openclaw068/SteadyStud/steadystud/morning_summary.txt

SteadyStud quote tracker — 2026-03-31 08:03 UTC
New quote-ish emails since last run: 45

- 2026-03-30 | Monica Devi <cs2@decimal.net> | RE: RFQ — SteadyStud — metal part + laser logo marking — Qty 50 / 100 / 500 / 1000 | 
- 2026-03-30 | Jason Lasica <jason@pittsburghlasercutting.com> | Re: RFQ — SteadyStud — metal part + laser logo marking — Qty 50 / 100 / 500 / 1000 | $125, $1,500, $500, $2,500
- 2026-03-30 | shanice@jlcpcb.com | Re: RFQ — SteadyStud — metal part + laser logo marking — Qty 50 / 100 / 500 / 1000 | 
- 2026-03-30 | magstud <magstud@agentmail.to> | RFQ — SteadyStud — metal part + laser logo marking — Qty 50 / 100 / 500 / 1000 | 
- 2026-03-30 | magstud <magstud@agentmail.to> | RFQ — SteadyStud — metal part + laser logo marking — Qty 50 / 100 / 500 / 1000 | 
- 2026-03-30 | magstud <magstud@agentmail.to> | RFQ — SteadyStud — metal part + laser logo marking — Qty 50 / 100 / 500 / 1000 | 
- 2026-03-30 | magstud <magstud@agentmail.to> | RFQ — SteadyStud — metal part + laser logo marking — Qty 50 / 100 / 500 / 1000 | 
- 2026-03-30 | magstud <magstud@agentmail.to> | RFQ — SteadyStud — metal part + laser logo marking — Qty 50 / 100 / 500 / 1000 | 
- 2026-03-30 | magstud <magstud@agentmail.to> | RFQ — SteadyStud — metal part + laser logo marking — Qty 50 / 100 / 500 / 1000 | 
- 2026-03-30 | magstud <magstud@agentmail.to> | RFQ — SteadyStud — metal part + laser logo marking — Qty 50 / 100 / 500 / 1000 | 
(+35 more)
