openclaw068/SteadyStud/steadystud/README_START_HERE.md

# SteadyStud — START HERE

## Current source of truth
- **v2 - reviewed (2026-03-14)/** ← canonical “current” folder

## Working areas
- **RFQs/** ← supplier outreach, quotes, and attachments (AgentMail exports)
- **02 - Product & Design/** ← CAD, specs, product design notes
- **03 - Manufacturing & Supply Chain/** ← manufacturing plan, DFM, cost-down
- **04 - Branding & Positioning/**
- **05 - Go-To-Market & Channels/**
- **06 - Financial Model/**
- **07 - Risks, Legal, IP/**
- **08 - Experiments & Roadmap/**

## Archive
- **_archive/** ← older drafts and duplicates moved here to keep the root clean

If something is missing, check `_archive/` before assuming it was deleted.
