openclaw068/SteadyStud/audits/RFQs/RFQ - Anodize + Laser.md

# RFQ — Anodize + Laser Mark (SteadyStud)

Hi {VendorName},

I’m looking for a quote to finish and laser-mark small aluminum parts for a handheld tool called **SteadyStud**.

## Project: SteadyStud (premium magnetic stud finder)

**Quantity tiers to quote:** 200 / 500 / 1000 units

**Material:** 6061-T6 aluminum (confirm if alternative alloy materially cheaper)

**Finish:** Type II anodize — *use the cheapest standard color you already run* (clear or black often cheapest; quote both if price differs). No dye-matching requirement.

**Branding:** laser marking only (logo + minimal text). No paint fill.

**Magnets:** we will install magnets ourselves for the first run (quote part without magnets).

**Files provided (intake):** STEP v1 + supporting DWG/DXF as needed.

**Shipping:** deliver to ZIP 55117.

**Notes:** This is a pro tool meant to slide on painted drywall; edges must be wall-safe.

## Scope requested
1) **Type II anodize** (cheapest standard color you run; quote clear vs black if different)
2) **Laser mark**: logo + minimal text on one face (vector artwork will be provided)

## Quality requirements
- Cosmetic: consistent color within a batch
- Functional: edges must remain smooth/wall-safe after finishing

## Quote format
Please include:
- Minimum batch charges
- Unit price at 200 / 500 / 1000
- Lead time
- Any prep requirements (masking, racking points, pre-finish expectations)

Thanks,
{YourName}
{Phone}
