openclaw068/SteadyStud/audits/RFQs/RFQ - Machine Shop.md

# RFQ — Machine shop (SteadyStud)

Hi {ShopName},

I’m looking for a quote for a small production run of an aluminum handheld tool called **SteadyStud**.

## Project: SteadyStud (premium magnetic stud finder)

**Quantity tiers to quote:** 200 / 500 / 1000 units

**Material:** 6061-T6 aluminum (confirm if alternative alloy materially cheaper)

**Finish:** Type II anodize — *use the cheapest standard color you already run* (clear or black often cheapest; quote both if price differs). No dye-matching requirement.

**Branding:** laser marking only (logo + minimal text). No paint fill.

**Magnets:** we will install magnets ourselves for the first run (quote part without magnets).

**Files provided (intake):** STEP v1 + supporting DWG/DXF as needed.

**Shipping:** deliver to ZIP 55117.

**Notes:** This is a pro tool meant to slide on painted drywall; edges must be wall-safe.

## Scope requested
Please quote as separate line items (so we can mix-and-match suppliers):
1) **Blank + machining** (no finish)
2) **Deburr + edge break / tumble** (wall-safe)
3) **Packaging for shipment** (bulk pack OK; no retail packaging)

## Manufacturing approach
We’re aiming for a cost-effective approach compatible with:
- 0.25" plate blank (waterjet/laser) + limited CNC where required
- OR your recommended equivalent process for best cost/quality

## Tolerances
We are okay with **general machining tolerances** suitable for a hand tool (no press fits). Please call out any features that would drive time/cost.

## Quote format
Please include:
- Unit price at 200 / 500 / 1000
- Setup/NRE charges
- Lead time
- Assumed process steps (cut method, CNC ops, deburr/tumble)
- Any DFM recommendations to reduce cost while preserving a stiff, solid feel

Thanks,
{YourName}
{Phone}
