openclaw068/SteadyStud/audits/01 - Market & Customer Research/SteadyStud - Research Notes (Cited).md

# SteadyStud — Research notes (cited)

## 1) Category basics: magnetic stud finders
Magnetic stud finders locate studs by detecting **metal fasteners** (nails/screws) used to secure drywall to studs; users typically confirm by finding multiple fasteners and inferring stud location/spacing.

Source: Wikipedia — Stud finder (Magnetic stud finders section): https://en.wikipedia.org/wiki/Stud_finder

## 2) What credible reviewers recommend (signals for pro-speed positioning)
### Wirecutter (NYT) — prefers magnetic for reliability
Wirecutter states electronic stud finders are often unreliable and highlights magnetic stud finders as simple and reliable; recommends the C.H. Hanson 03040 as top pick and notes that the pointed end + onboard level simplify marking.

Source: NYT Wirecutter — The Best Stud Finder for Home Use: https://www.nytimes.com/wirecutter/reviews/best-stud-finder/

Implications for SteadyStud:
- “Fast and accurate” + “simple magnet” is a validated narrative.
- Marking and speed features matter (your notch is in the same family as “pointed end simplifies marking”).

## 3) Strong-magnet competitor claim (pro trades)
Rack-A-Tiers sells the “Stud Ball” and claims **27 lbs of pull** and detection through **up to 5/8" drywall** and **up to 3/4" plywood**.

Sources:
- Rack-A-Tiers product page: https://rack-a-tiers.com/product/stud-ball-magnetic-stud-finder/
- ConstructionFastening retailer page (repeats 27 lbs pull + material thickness claims): https://www.constructionfastening.net/Rack_A_Tiers_Stud_Ball_Stud_Finder_p/52300.htm

Implications:
- “Magnet strength” is a marketing axis pros will understand.
- If SteadyStud competes on pro-speed, we should define a clear magnet performance target and test protocol.

## 4) Commodity price anchor (tentative)
Home Depot listing snippets repeatedly show The StudBuddy model 000107 at **$10.97**.

Source (snippet only; direct fetch blocked by 403):
- Brave search results for Home Depot product page: https://www.homedepot.com/p/The-StudBuddy-Magnetic-Stud-Finder-000107/205554450

Implications:
- Premium pro-speed pricing ($15–$25) needs a clear reason to exist: faster workflow (marking notch), better wall-safe glide, stronger magnet feel, durability.

## Notes / hallucination controls
- Home Depot/Lowe’s pages are blocked in this environment (403), so prices from those pages are currently supported only by search snippets. We treat them as *directional* until confirmed by an accessible retailer source.
