openclaw068/SteadyStud/cad/v3/out/SteadyStud_v3A_drawing.pdf

# STEADYSTUD v3A — 2D-CUT ALUMINUM BODY, 3 X 1/2 X 1/4 IN MAGNET

Laser/waterjet profile from 0.250" plate. No machining. Dimensions in inches. Drawing generated from the laser DXF.

### FRONT FACE (marked side) — 1:1 when PDF printed at 100%

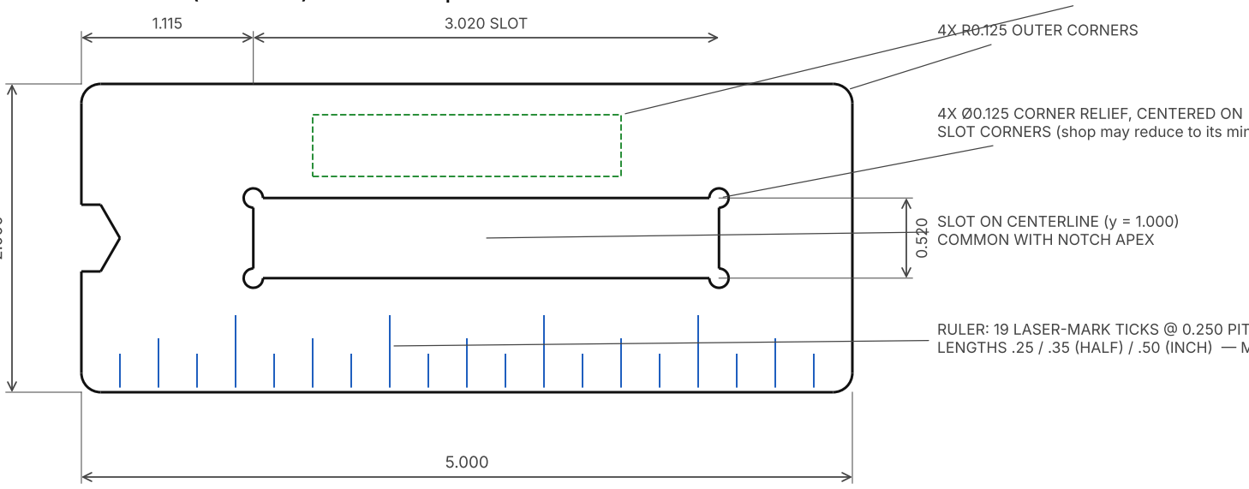
[picture p1: figure]
3.020 SLOT; 4X Ø0.125 CORNER RELIEF, CENTERED ON; SLOT ON CENTERLINE (y = 1.000); COMMON WITH NOTCH APEX; 4X R0.125 OUTER CORNERS

2.000

SLOT CORNERS (shop may reduce to its min hole)

RULER: 19 LASER-MARK TICKS @ 0.250 PITCH
LENGTHS .25 / .35 (HALF) / .50 (INCH) — MARK, NOT CUT

LOGO ZONE 2.00 x 0.40 (laser mark) — moved from v1

### DETAIL A — END NOTCH (2.5:1)

### unchanged from v1 STEP

0.433

0.125

0.250 TO APEX

60° INCLUDED V
℄

### SECTION B — THROUGH CENTERLINE (thickness shown 2:1)

MAGNET 3 x 1/2 x 1/4 in (magnetized through thickness)

BACK PAD (wall side) — see note 7 .250

SLOT 3.020 / MAGNET 3.000

Magnet bonded FLUSH TO BACK (wall) face. Any thickness mismatch is taken on the front face.

## NOTES

1. MATERIAL: 6061-T6 aluminum plate, 0.250" nominal.
2. PROCESS: through-cut profile only (fiber laser or waterjet). No milling, no chamfers.
3. TOLERANCES: profile ±0.005; slot +0.005/-0.000 vs nominal shown; thickness per mill plate.
4. EDGES: tumble/vibratory deburr. Break all edges .010–.020. No sharp edges (wall-safe).
5. FINISH: Type II anodize, black (alt: clear). Quote as-cut + tumbled as alternate.
6. MARKING: laser mark after anodize — layer MARK (ruler) and LOGO_ZONE. Not engraved.
7. BACK PAD: adhesive-backed PET felt or UHMW tape ≤0.5 mm, die-cut to SteadyStud_v3_back_pad.dxf (outline inset 0.020). Covers magnet; wall-contact face.
8. MAGNET: 3 x 1/2 x 1/4 in NdFeB N42, Ni-Cu-Ni, magnetized through thickness. Source: K&J Magnetics BZ084 (stock). Bond with 2-part epoxy; polarity uniform across lot.
9. USE: hold notch UP (long axis vertical). Mark at notch apex = fastener column = stud line.
STATUS | PROTOTYPE / RFQ — NOT RELEASED
DATE | 2026-10-12
UNITS | inch
SUPERSEDES | Stud Finer v1 (for quoting)
SOURCE | cad/v3/steadystud_v3.py
MAGNET | 3 x 1/2 x 1/4 in
PART | SteadyStud body v3A
