openclaw068/SteadyStud/cad/v3/out/SteadyStud_v3A_laser_marking_drawing.pdf

# STEADYSTUD v3A — LASER MARKING DRAWING (INCHES)

Grey = cut outline (reference only). BLACK = laser mark on the FRONT face. All dimensions in inches.

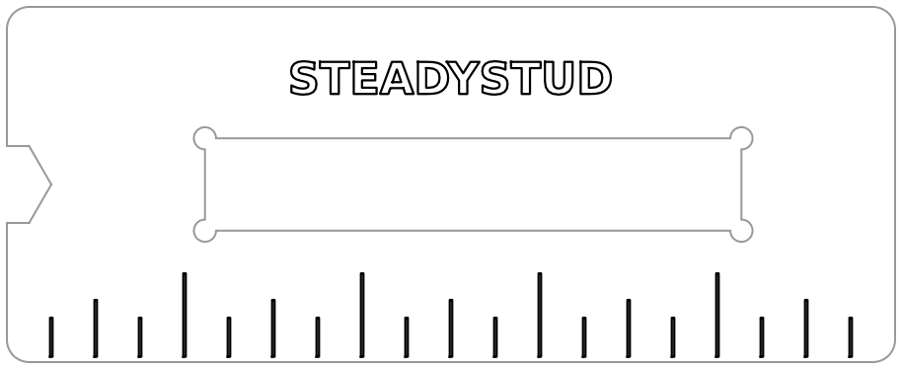
[picture p2: figure]

MARK 1 — RULER: 19 lines along the bottom long edge, 0.250 pitch, first line 0.250 from the notched end.

Line lengths: 0.250 at quarter-inch, 0.350 at half-inch, 0.500 at whole-inch positions. Line width ≈ 0.014.

Lines start 0.030 in from the edge. Positions measured from the notched end of the part.

MARK 2 — TEXT: "STEADYSTUD", about 1.80 × 0.19, centered in a 2.000 × 0.400 zone; zone center 2.500 from the notched end, 1.600 from the ruler edge.

FACE: front face only (notch on the LEFT, ruler along the BOTTOM edge). Do not mark the back.

Marks only — NOT cut or engraved through. Fill all closed BLACK shapes. 1:1 when printed at 100% on letter paper.

Matching file: SteadyStud_v3A_laser_marking_inch.dxf (units: inch).
