openclaw068/SteadyStud/memory-projects-steadystud/orchestrator/index.md

# SteadyStud — Orchestrator Pipeline

## Backlog

## In Progress

## Review

## Done
