openclaw068/SteadyStud/audits/Vacuum Receipt.pdf

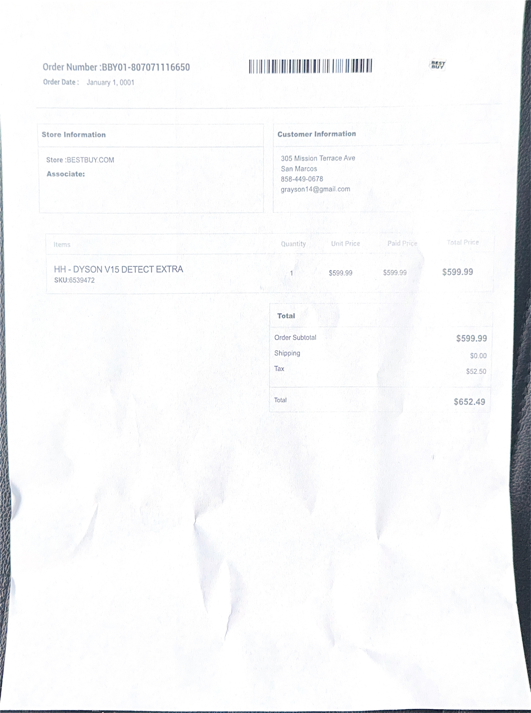
[picture p4: page 1]
