openclaw068/SteadyStud/steadystud/attachments/2026-03-17__037f37b3-56c0-4062-bf5f-1efe351ddcb5__SteadyStud_2D_Top_View_APPROVED.pdf

## STEADYSTUD — TOP VIEW (REFERENCE) — APPROVED

For quote context: outline projection from STEP + logo placement + overall dims

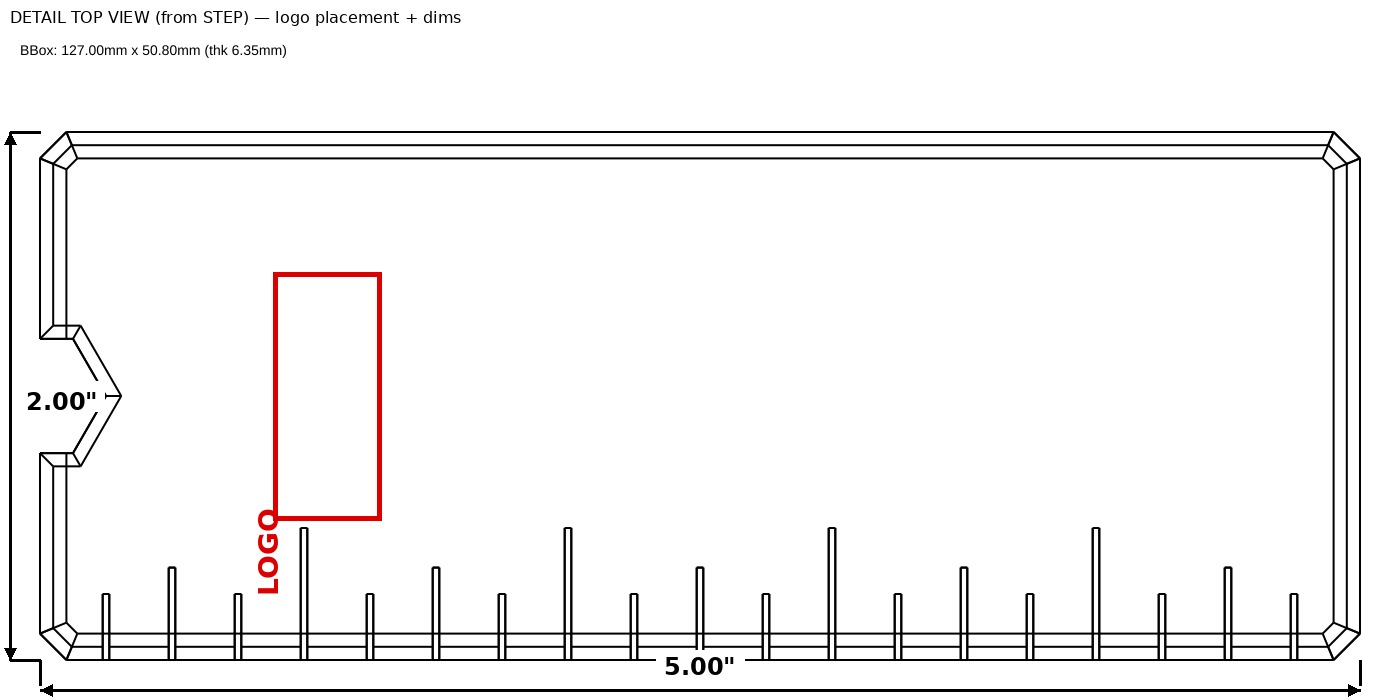
[picture p5: figure]
