openclaw068/SteadyStud/cad/v3/out/SteadyStud_v3A_drawing.png

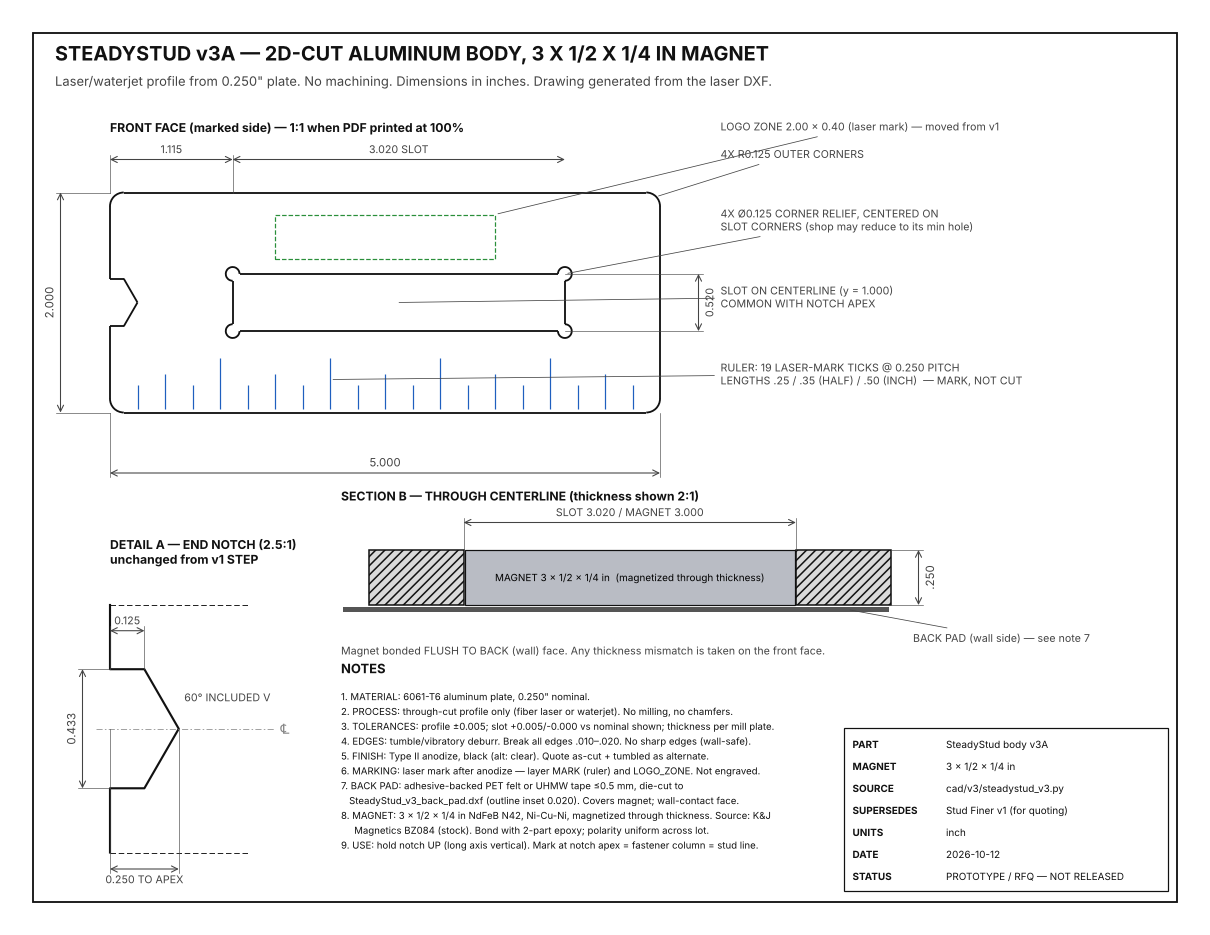
cad/v3/out/SteadyStud_v3A_drawing.png
