openclaw068/SteadyStud/cad/v3/out/SteadyStud_v3A_render.png

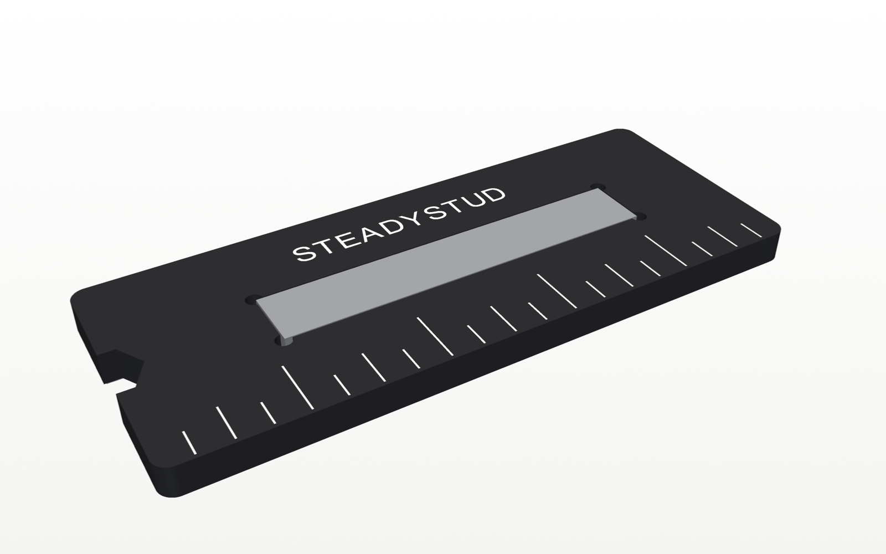
cad/v3/out/SteadyStud_v3A_render.png
