openclaw068/SteadyStud/cad/v3/out/SteadyStud_v3B_exploded.png

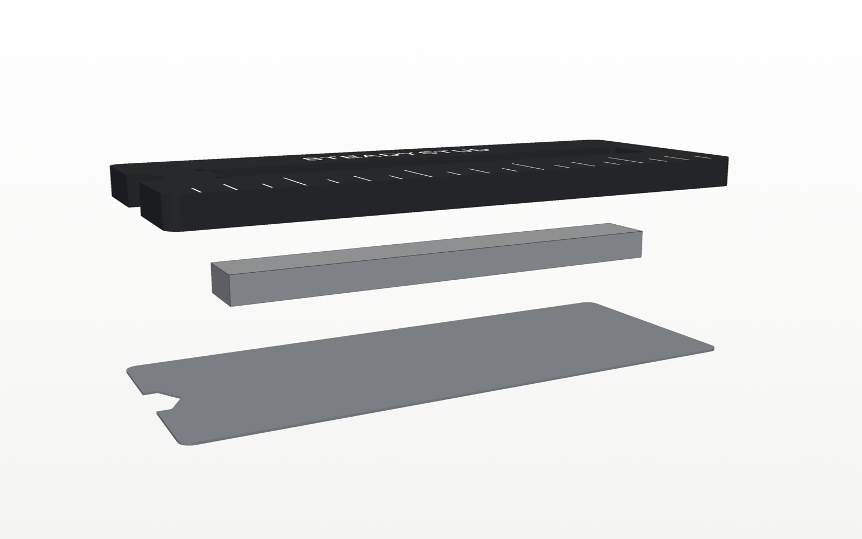
cad/v3/out/SteadyStud_v3B_exploded.png
