openclaw068/SteadyStud/cad/v3/out/SteadyStud_v3C_drawing.png

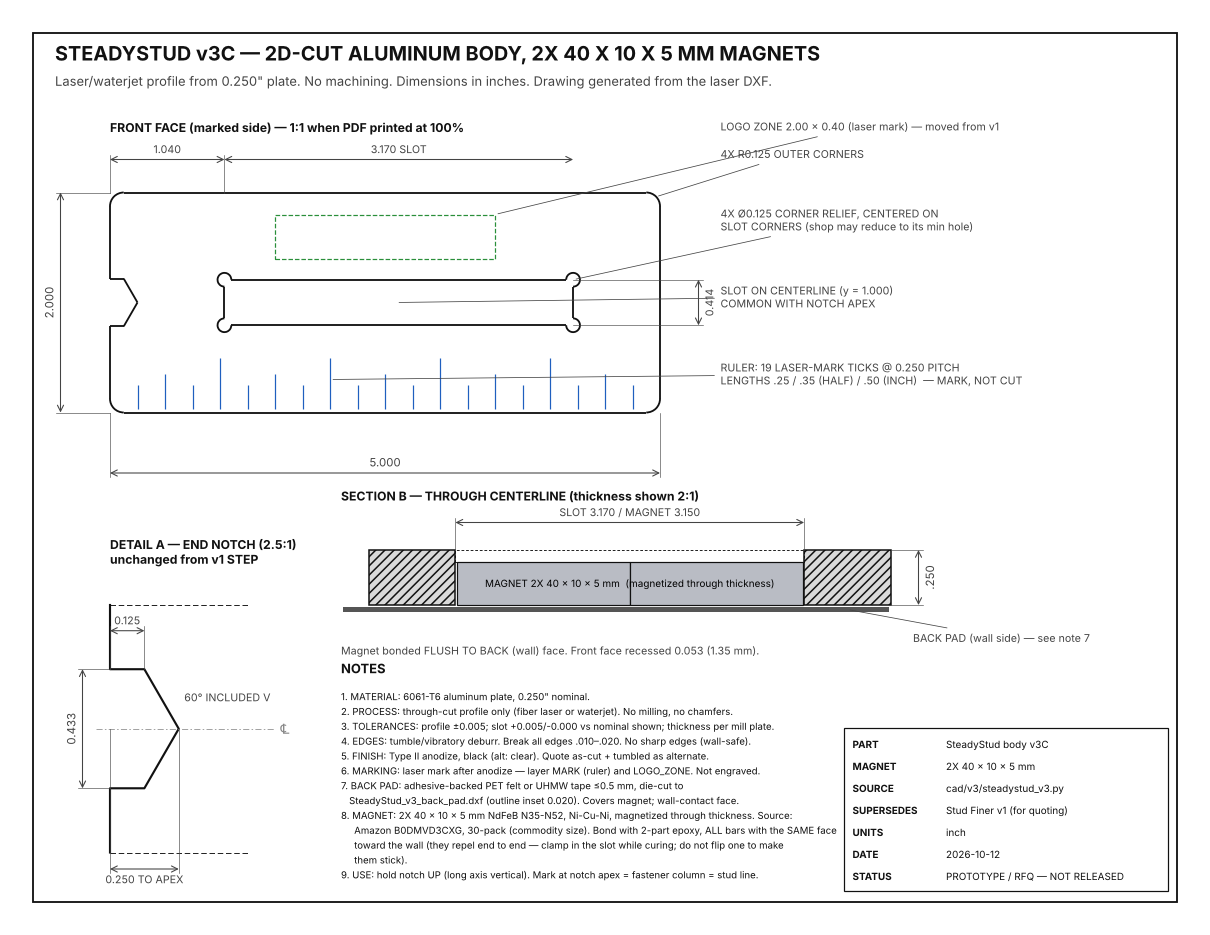
cad/v3/out/SteadyStud_v3C_drawing.png
