openclaw068/SteadyStud/cad/v3/out/SteadyStud_v3B_assembly.step

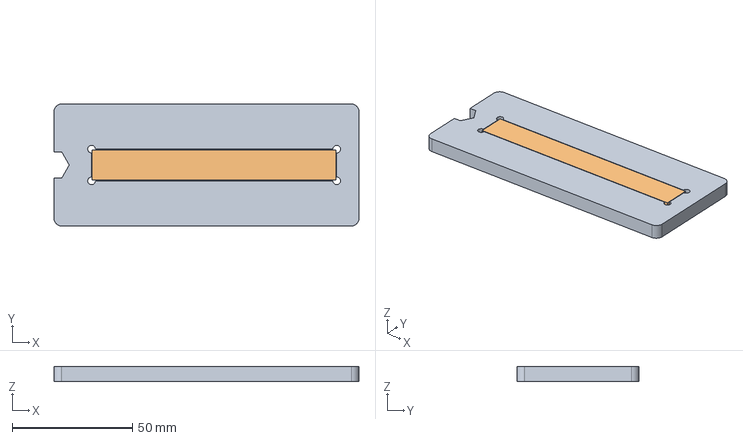
[picture p10: CAD file, 2026-10-13]
cad/v3/out/SteadyStud_v3B_assembly.step
127.0 x 50.8 x 6.35 mm
