openclaw068/SteadyStud/cad/v3/out/SteadyStud_v3C_assembly.step

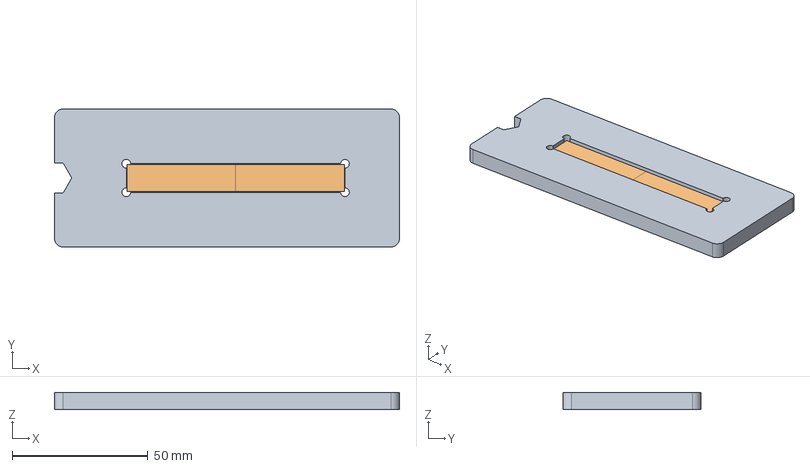
[picture p11: CAD file, 2026-10-13]
cad/v3/out/SteadyStud_v3C_assembly.step
127.0 x 50.8 x 6.35 mm
