openclaw068/SteadyStud/cad/v3/out/SteadyStud_v3A_laser_marking_inch.dxf

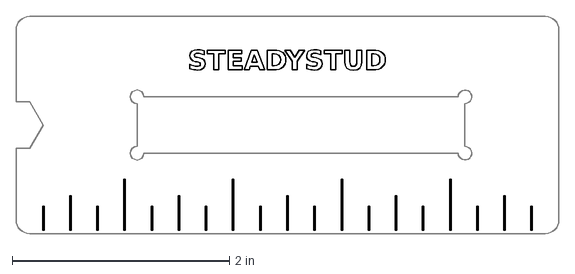
[picture p12: CAD file, 2026-10-13]
cad/v3/out/SteadyStud_v3A_laser_marking_inch.dxf
5.00 x 2.00 in
