openclaw068/SteadyStud/steadystud/attachments/2026-03-17__742ad145-59e5-40db-ae1a-9b0c37fdb010__Magnetic Stud Finer v1.step

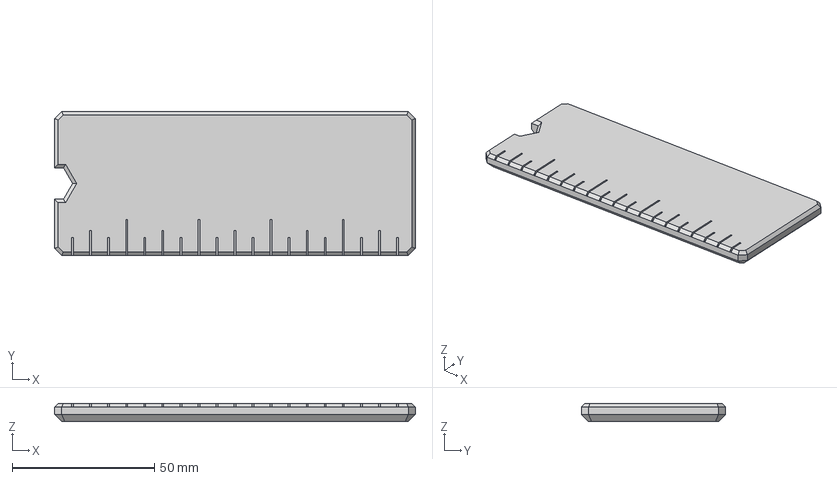
[picture p13: CAD file, 2026-10-11]
steadystud/attachments/2026-03-17__742ad145-59e5-40db-ae1a-9b0c37fdb010__Magnetic Stud Finer v1.step
127.0 x 50.8 x 6.35 mm
