openclaw068/SteadyStud/cad/v3/out/SteadyStud_v3_back_pad.dxf

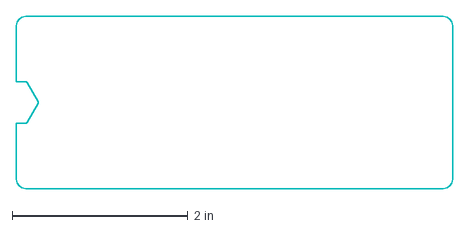
[picture p14: CAD file, 2026-10-13]
cad/v3/out/SteadyStud_v3_back_pad.dxf
4.96 x 1.96 in
