openclaw068/SteadyStud/cad/v3/out/SteadyStud_v3C_laser.dxf

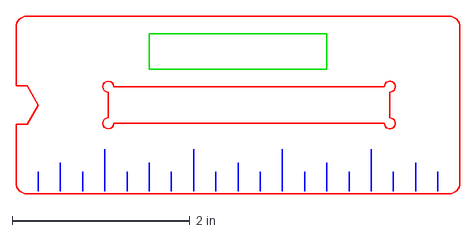
[picture p15: CAD file, 2026-10-13]
cad/v3/out/SteadyStud_v3C_laser.dxf
5.00 x 2.00 in
