openclaw068/SteadyStud/cad/v3/out/SteadyStud_v3B_CUT_ONLY_inch.dxf

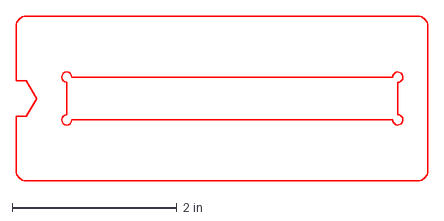
[picture p17: CAD file, 2026-10-13]
cad/v3/out/SteadyStud_v3B_CUT_ONLY_inch.dxf
5.00 x 2.00 in
