openclaw068/SteadyStud/cad/v3/out/SteadyStud_v3A_body.step

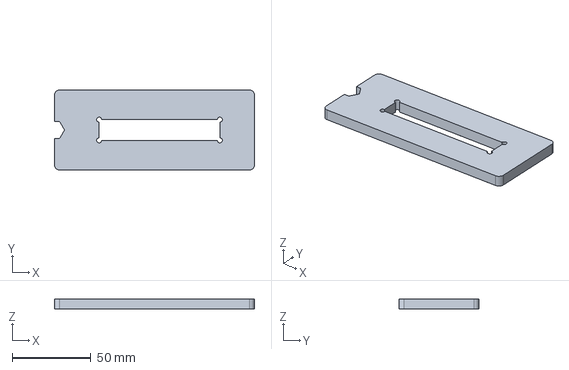
[picture p20: CAD file, 2026-10-13]
cad/v3/out/SteadyStud_v3A_body.step
127.0 x 50.8 x 6.35 mm
