openclaw068/SteadyStud/(list of files, cad)

Other CAD files:
cad/v3/out/SteadyStud_v3A_assembly.step
audits/Magnetic Stud Finer v1 v2.dxf
audits/Magnetic Stud Finder.dwg
cad/v3/out/SteadyStud_v3C_body_mm.stl
steadystud/rfq_files/Magnetic Stud Finer v1 v2.dxf
audits/Magnetic Stud Finer v2.dwg
cad/v3/out/SteadyStud_v3A_PRINT.step
cad/v3/out/SteadyStud_v3C_PRINT_mm.stl
cad/v3/out/SteadyStud_v3C_PRINT.step
cad/v3/out/SteadyStud_v3C_body.step
cad/v3/out/SteadyStud_v3B_PRINT.step
cad/v3/out/SteadyStud_v3B_body.step
cad/v3/out/SteadyStud_v3A_PRINT_mm.stl
cad/v3/out/SteadyStud_v3B_PRINT_mm.stl
cad/v3/out/SteadyStud_v3A_body_mm.stl
cad/v3/out/SteadyStud_v3B_body_mm.stl
audits/Magnetic Stud Finer v1 v2.ipt
audits/Magnetic Stud Finer v1.DXF
audits/Magnetic Stud Finer v1.dwg
audits/Magnetic Stud Finer v1.f3d
