openclaw068/SteadyStud/memory-projects-steadystud/orchestrator/packets/2026-03-27__001-quote-packet-next-steps/artifacts/README.md

# Artifacts

Drop any files/patches/links produced by the packet here.
