openclaw068/SteadyStud/memory-projects-steadystud/orchestrator/packets/2026-03-27__001-quote-packet-next-steps/approval_checklist.md

# Approval checklist (Grayson)

## Safe by default (no approval needed)
- [ ] Write/update docs in workspace
- [ ] Create plan/checklists
- [ ] Run read-only diagnostics (ls/cat/grep/git status)

## Requires explicit approval
- [ ] Code changes (patches/commits)
- [ ] Running tests that modify state (rare)
- [ ] Installs / dependency changes
- [ ] Any external comms (email/messages/calls)
- [ ] Any infra/config change (OpenClaw config, systemd, Docker, ports)
- [ ] Purchases / vendor RFQs / quote submissions

## This packet requests approval for:
- [ ] (fill)
