openclaw068/SteadyStud/memory-projects-steadystud/orchestrator/packets/2026-03-27__001-quote-packet-next-steps/brief.md

# Brief

## Goal
(One sentence.)

## Context
- Project:
- Why now:
- Constraints:

## Inputs / links
- 

## Non-goals
-
