openclaw068/SteadyStud/memory-projects-steadystud/orchestrator/packets/2026-03-27__001-quote-packet-next-steps/contrarian_review.md

# Contrarian review

## Red flags
- 

## Missing assumptions
- 

## Cheaper / simpler alternative
- 

## What would fail in production?
-
