openclaw068/SteadyStud/memory-projects-steadystud/orchestrator/packets/2026-03-27__001-quote-packet-next-steps/delegations.md

# Delegations

## Who does what
- Orchestrator:
- Lane lead:
- Worker (research):
- Coding (implementation):
- QA (verification):

## Inputs provided to subagents
- 

## Expected outputs
-
