openclaw068/SteadyStud/memory-projects-steadystud/orchestrator/packets/2026-03-27__001-quote-packet-next-steps/plan.md

# Plan

## Proposed approach

## Tasks (Backlog → In Progress → Review → Done)
- [ ] 

## Risks / unknowns
- 

## Rollback plan
- 

## Test plan
-
