openclaw068/SteadyStud/(commit log)

2026-10-11 Initial commit: SteadyStud business project — full handoff
    [2026-03-14__0b1bb00a-6a37-4209-9f03-f5d0137bc9f1__Part_Model.step, 2026-03-14__2c4a6db5-ba93-458a-a507-fee7dabb17aa__Part_Model.step, 2026-03-14__403e2d42-910d-44a1-b295-ba91b343dd40__Part_Model.step, 2026-03-14__4cf9c3ce-1eac-4198-9649-9c667186cc2b__Part_Model.step, 2026-03-14__52ee6604-20ba-4400-938d-04e34b12eac9__Part_Model.step, 2026-03-14__76202c1c-24ab-47e8-9d50-b742fa85797b__Part_Model.ste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]
2026-10-12 Add SteadyStud v3 redesign: 2D-cut aluminum body with bar magnet
    Cost-down redesign of the v1 STEP so the body can be laser/waterjet cut
    from 1/4" plate with no milling:
    - Same 5.000 x 2.000 x 0.250 in envelope and end V-notch as v1
    - Chamfers removed (tumble deburr); 45-deg corners -> R0.125
    - Ruler moved from engraved grooves to laser mark
    - Centerline through-slot for a 1/2 x 1/4 in bar magnet: 3 in (v3A,
    K&J BZ084 stock) and 4 in (v3B, custom)
    - Back pad outline for an adhesive felt/UHMW wall-contact layer
    All STEP files declare INCH units and DXFs set $INSUNITS=1, so shops read
    the same numbers as the design (fixes an earlier export that labeled inch
    values as millimetres). STL is wr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
    [SteadyStud_v3A_CUT_ONLY_inch.dxf, SteadyStud_v3A_assembly.step, SteadyStud_v3A_body.step, SteadyStud_v3A_body_mm.stl, SteadyStud_v3A_laser.dxf, SteadyStud_v3A_laser_marking_inch.dxf, SteadyStud_v3B_CUT_ONLY_inch.dxf, SteadyStud_v3B_assembly.step]
2026-10-12 Add 3D-print models of v3A/v3B with engraved ruler and logo
    The production body gets its ruler and logo by laser marking, which a print
    can't reproduce, so the plain body STL prints blank. print_v3.py cuts the
    19 ruler ticks (0.025 in wide) and STEADYSTUD text 0.020 in deep into the
    front face and exports a true-size mm STL plus an inch STEP for each variant.
    Claude-Session: https://claude.ai/code/session_01XcwTLztpQSHkfkYLax7QZC
    [SteadyStud_v3A_PRINT.step, SteadyStud_v3A_PRINT_mm.stl, SteadyStud_v3B_PRINT.step, SteadyStud_v3B_PRINT_mm.stl]
2026-10-13 Add v3C: low-cost variant using 2x 40x10x5 mm commodity magnets
    The 3 x 1/2 x 1/4 in bar for v3A is about $13 each. v3C instead uses two
    40 x 10 x 5 mm N-grade bars end to end (Amazon B0DMVD3CXG, 30-pack ~$0.67
    each, ~$1.33 per tool). Slot is 3.170 x 0.414 in (0.010 in clearance per
    side, ~0.2 mm worst case at the listed +/-0.05 mm magnet tolerance); the
    5 mm bars sit flush to the back face with a 1.35 mm front recess.
    Model changes to support it:
    - VARIANTS now describe a magnet row (count, l/w/t, grade, source) instead
    of a single length; slot, magnet, drawing notes and title block follow it
    - build_magnet returns each bar as its own solid, and export_step_inch
    writes every solid, so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
    [SteadyStud_v3A_CUT_ONLY_inch.dxf, SteadyStud_v3A_PRINT.step, SteadyStud_v3A_assembly.step, SteadyStud_v3A_body.step, SteadyStud_v3A_laser.dxf, SteadyStud_v3A_laser_marking_inch.dxf, SteadyStud_v3B_CUT_ONLY_inch.dxf, SteadyStud_v3B_PRINT.step]
